salemmlayeh/Digital-Tachometer-with-Microcontroller-Based-Signal-Processing/images/2.jpeg

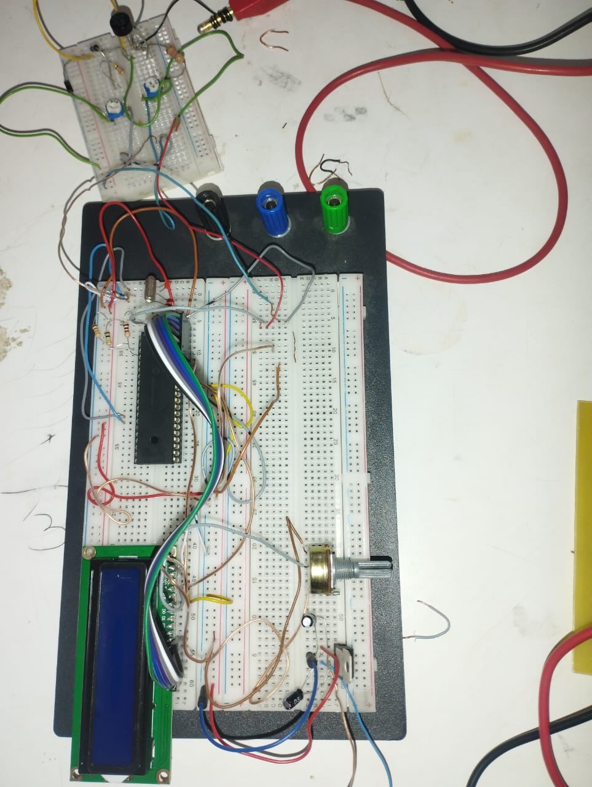
images/2.jpeg
