salemmlayeh/Digital-Tachometer-with-Microcontroller-Based-Signal-Processing/images/3.jpeg

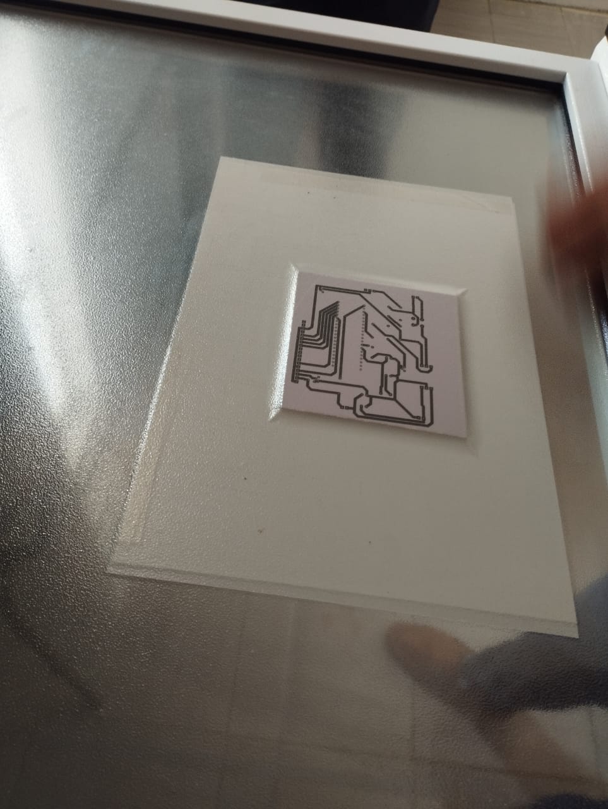
images/3.jpeg
