salemmlayeh/Digital-Tachometer-with-Microcontroller-Based-Signal-Processing/images/6.jpeg

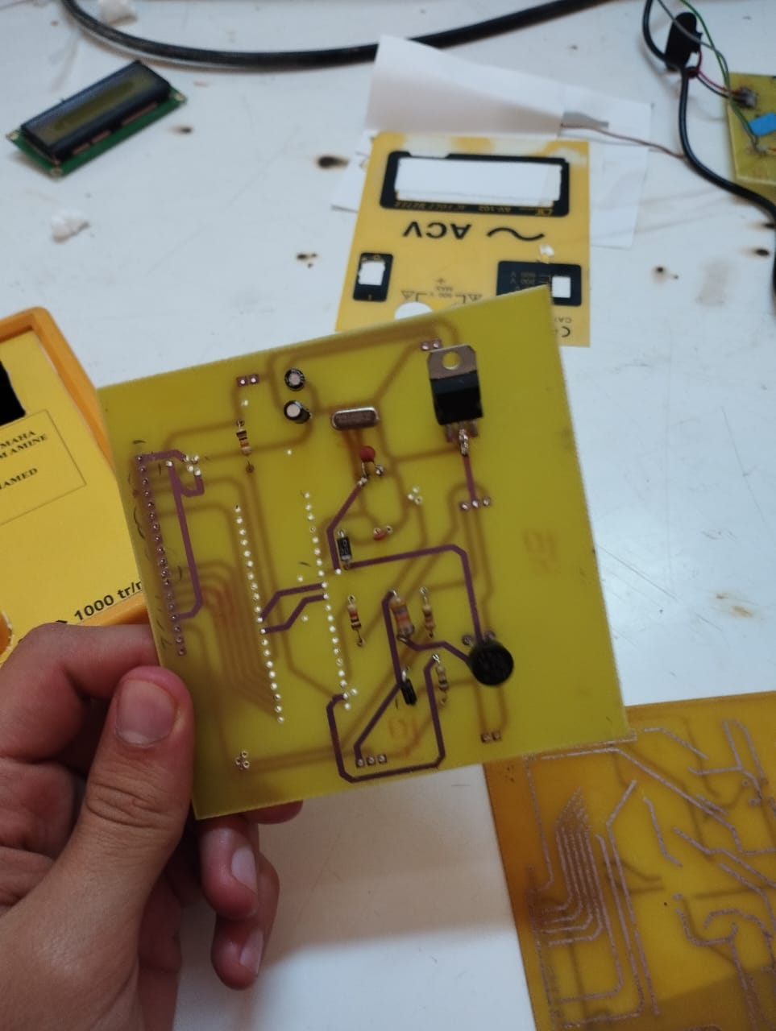
images/6.jpeg
