salemmlayeh/Digital-Tachometer-with-Microcontroller-Based-Signal-Processing/partie1 de tachy.PDF

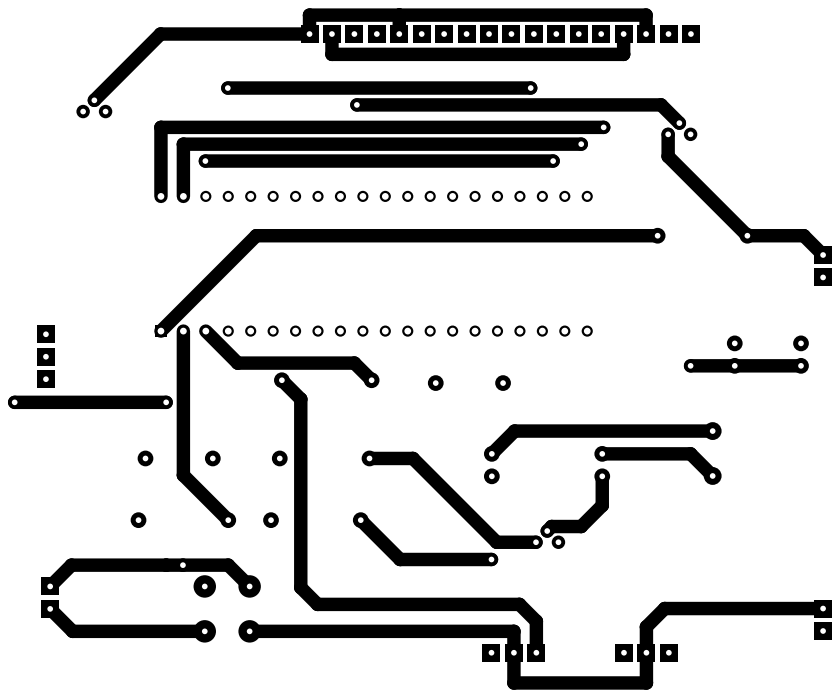
[picture p12: page 1]
