salemmlayeh/Digital-Tachometer-with-Microcontroller-Based-Signal-Processing/(list of files, drawings)

Other design files:
partie1 de tachy (1).LYT
partie1 de tachy [20250514, 17-05-37].pdsprj
partie1 de tachy [20250514, 17-05-49].pdsprj
partie1 de tachy [20250517, 21-07-53].pdsprj
partie1 de tachy.DSN
